Bassig1/2DX3-Project-/Python/DemoFront.PNG

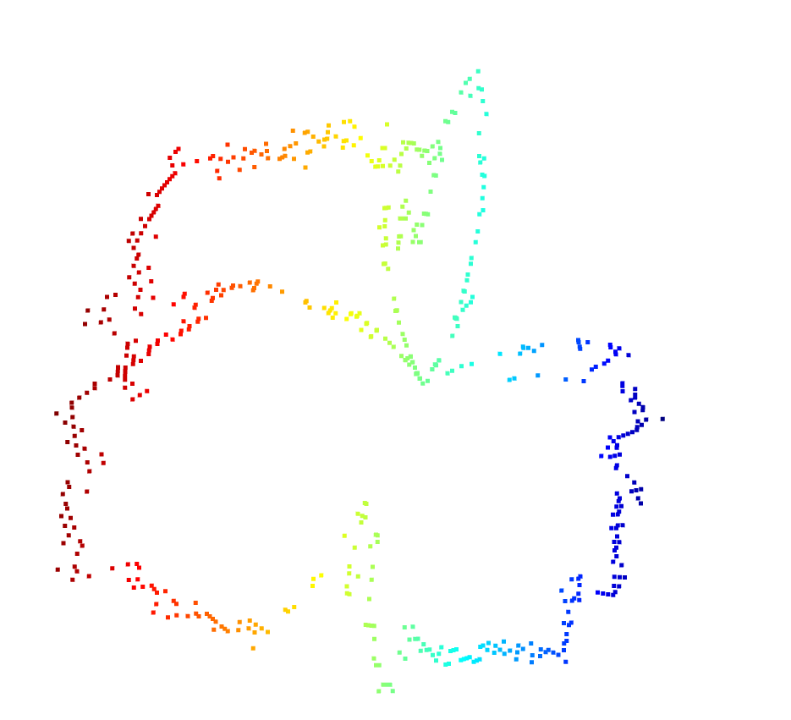
Python/DemoFront.PNG
