Bassig1/2DX3-Project-/Python/DemoSide.PNG

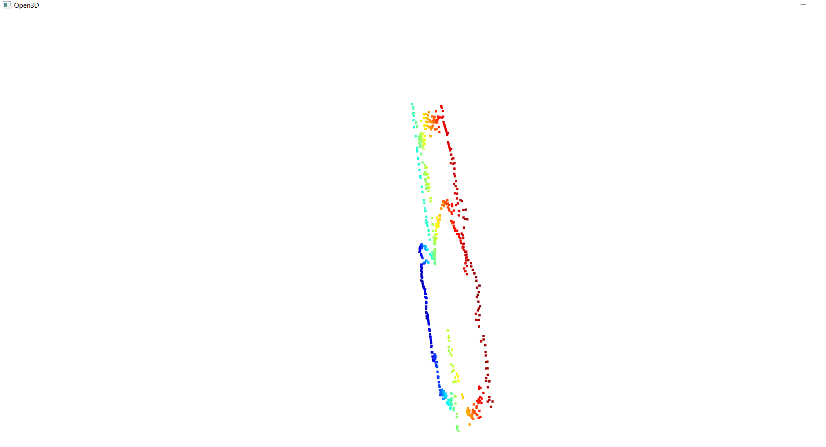
Python/DemoSide.PNG
