Bassig1/2DX3-Project-/Python/HallwayFront.PNG

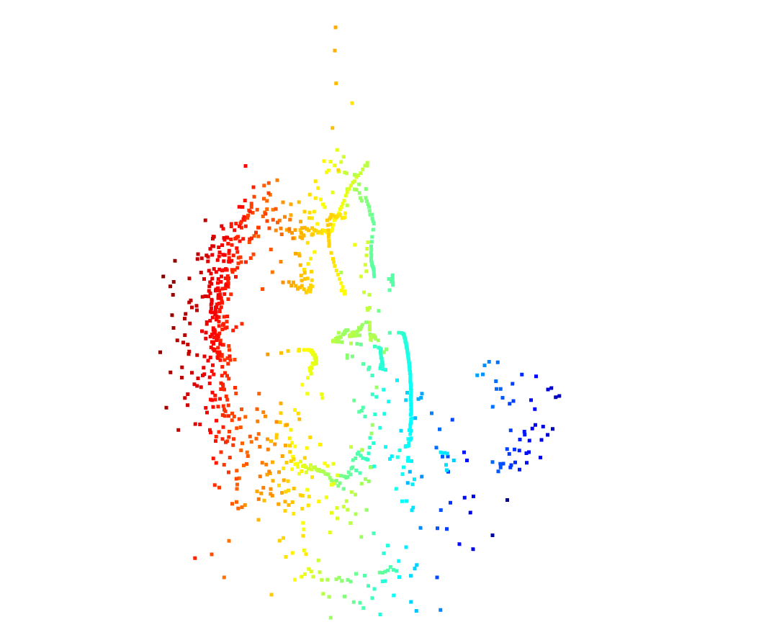
Python/HallwayFront.PNG
